andyzhp234/8-Bit-Breadboard-Computer/RAM_Programmer/README.md

# Code to Program the RAM Modules of the 8-bit computer

This RAM Programmer is designed to facilitate the loading of programs from a PC into an 8-bit breadboard computer via an Arduino interface.

## Basic Commands:

NOP : No Operations <br>
LDA : Load from memory to A <br>
ADD : Add from memory with current A and store in A <br>
SUB : Same above but sub <br>
STA : Store value in Register A to Memory <br>
LDI : Load Immediate values To A <br>
JMP : JMP to specific lines <br>
JC  : Jump when Carry flag is on <br>
JZ  : Jump when zero flag is on <br>
OUT : Output to 7-segment LED <br>
HLT : Halt the program <br>
