andyzhp234/8-Bit-Breadboard-Computer/Images/IMG_3965.jpg

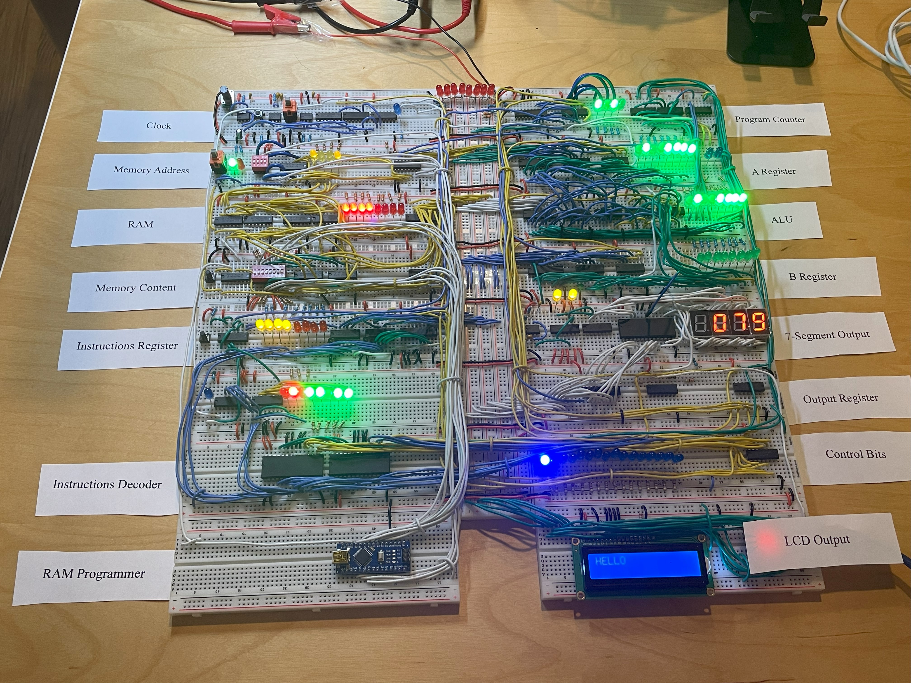
Images/IMG_3965.jpg
