andyzhp234/8-Bit-Breadboard-Computer/Schematics/a-register.png

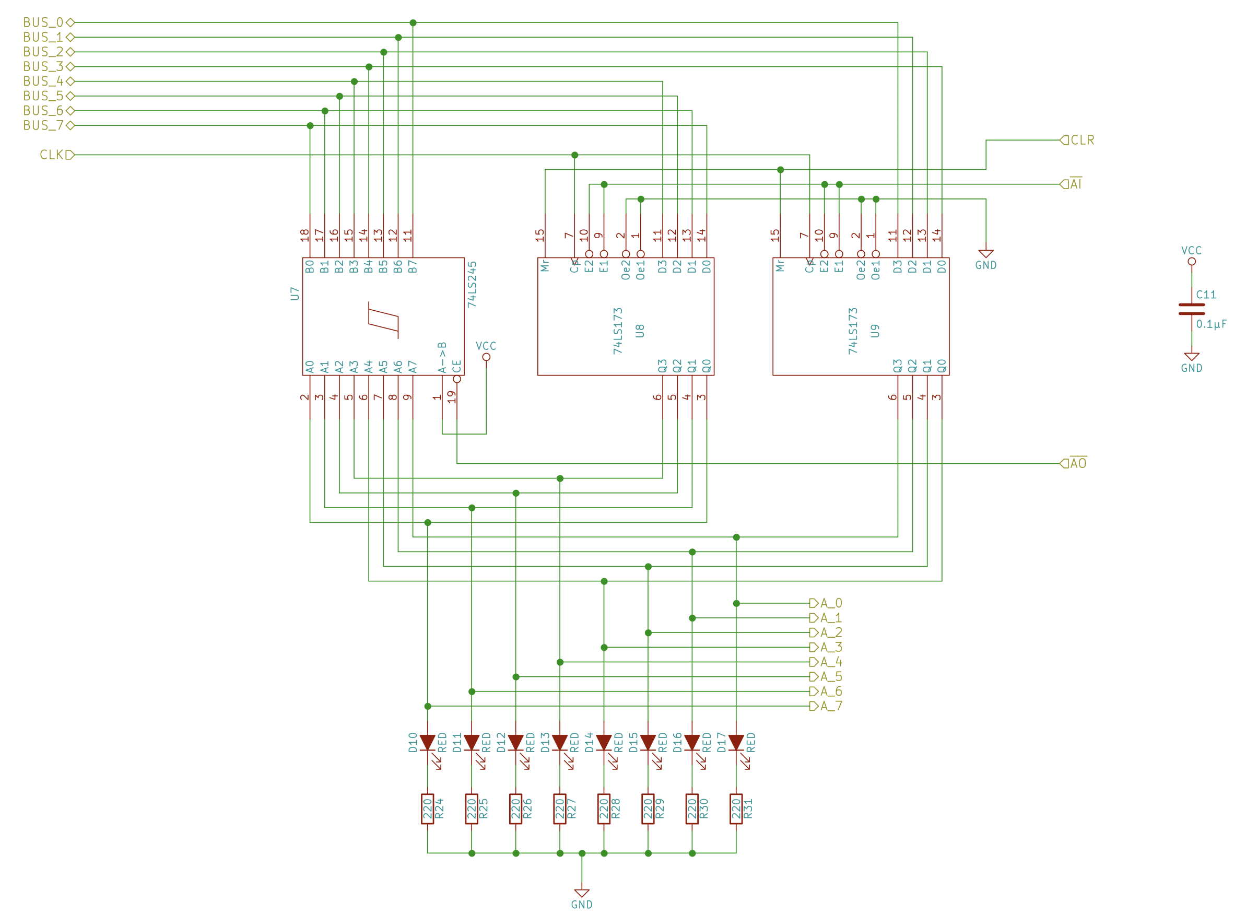
Schematics/a-register.png
