andyzhp234/8-Bit-Breadboard-Computer/Schematics/alu.png

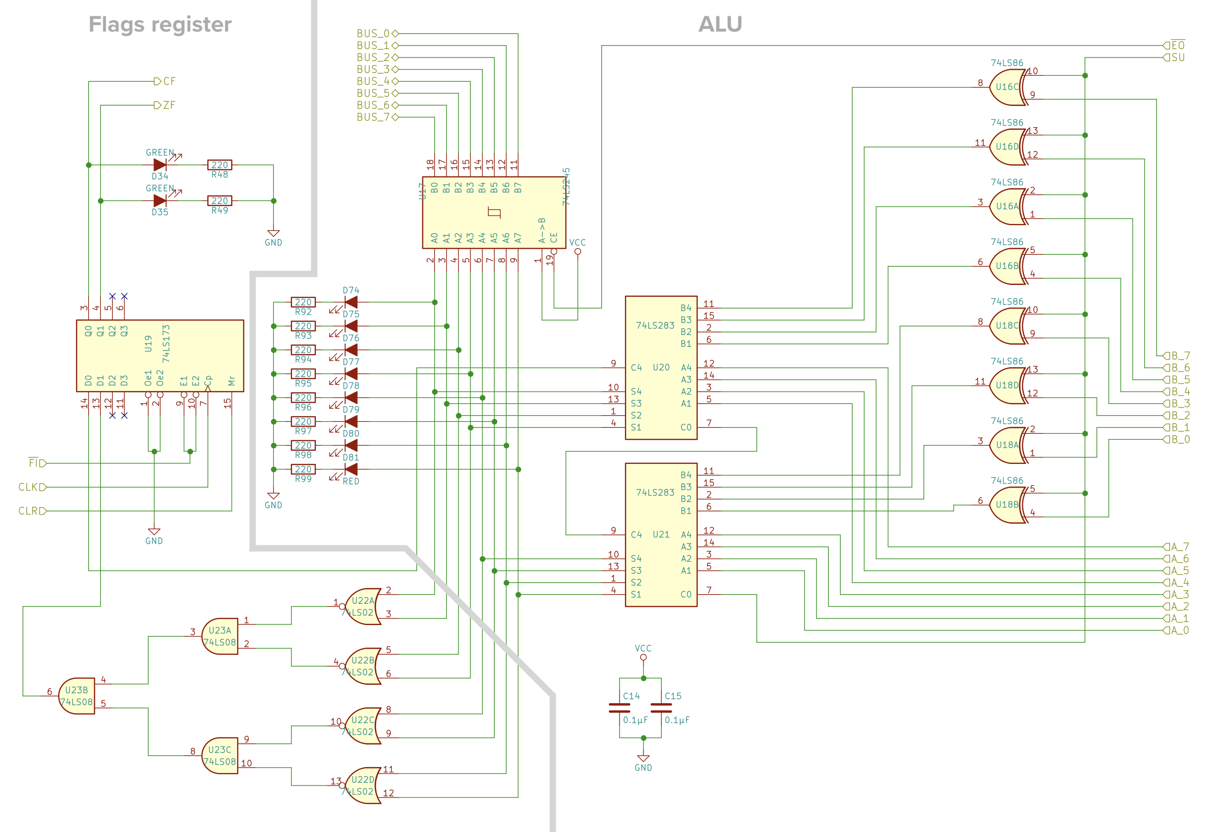
Schematics/alu.png
