andyzhp234/8-Bit-Breadboard-Computer/Schematics/b-register.png

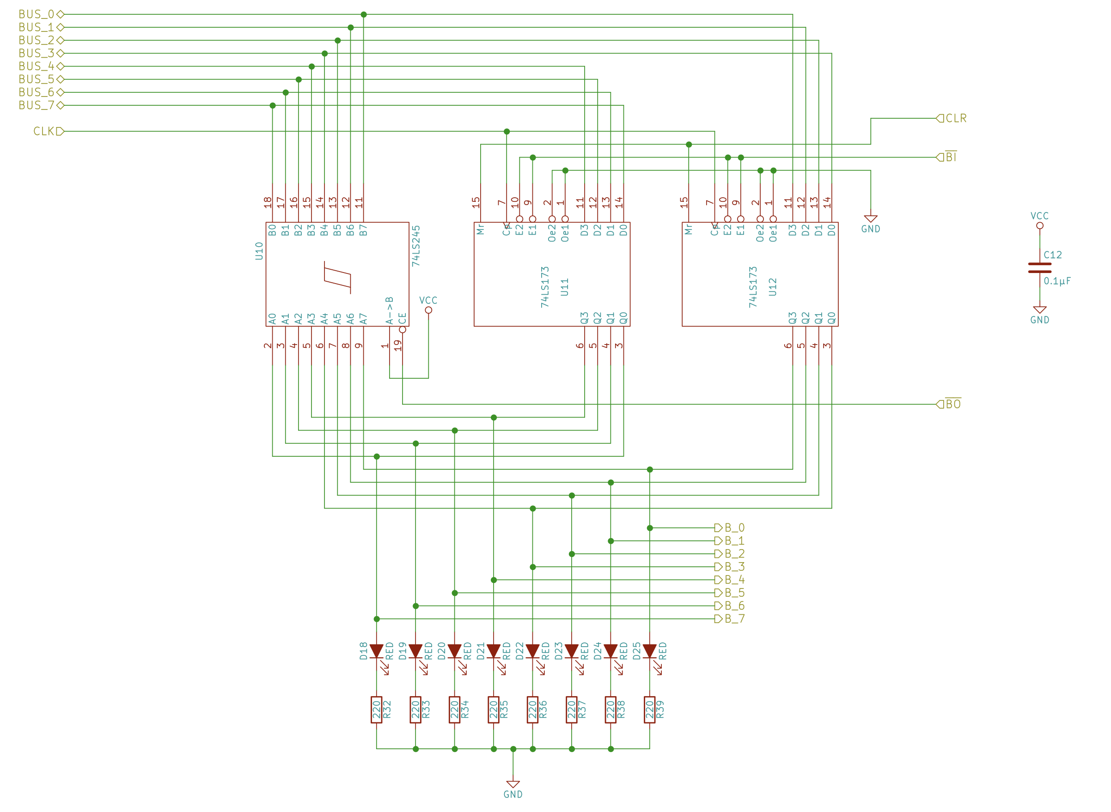
Schematics/b-register.png
