andyzhp234/8-Bit-Breadboard-Computer/Schematics/clock.png

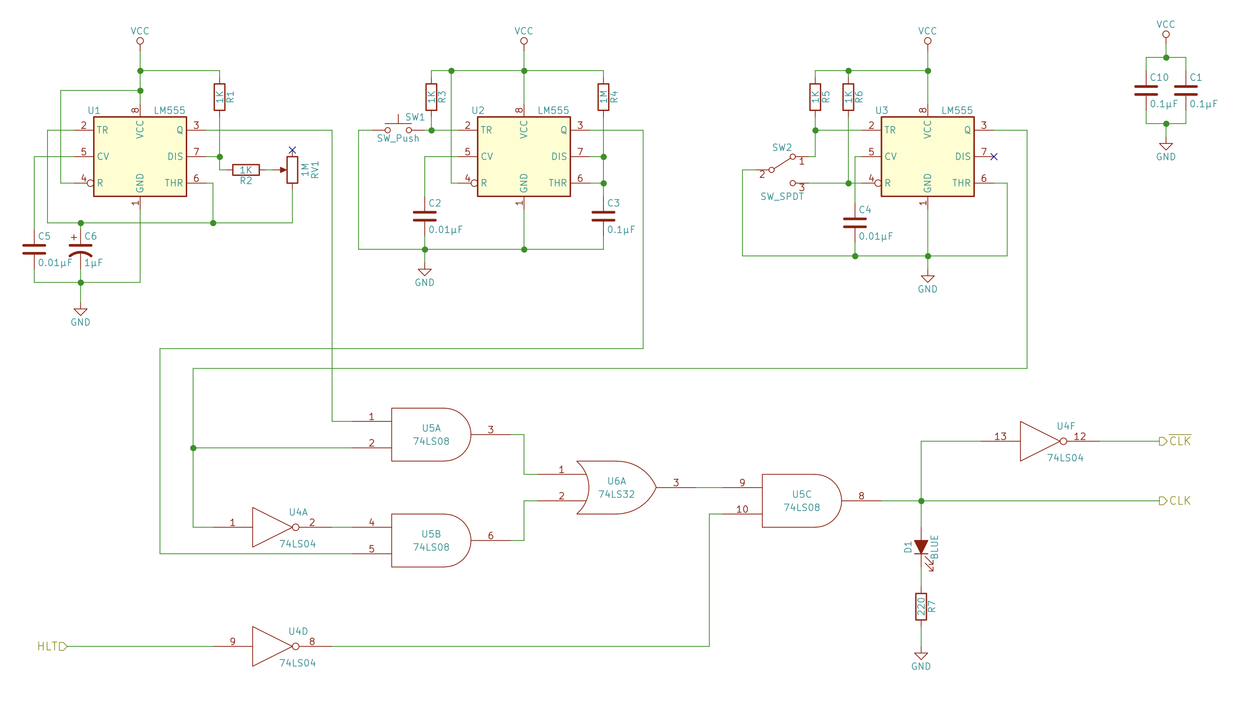
Schematics/clock.png
