andyzhp234/8-Bit-Breadboard-Computer/Schematics/control.png

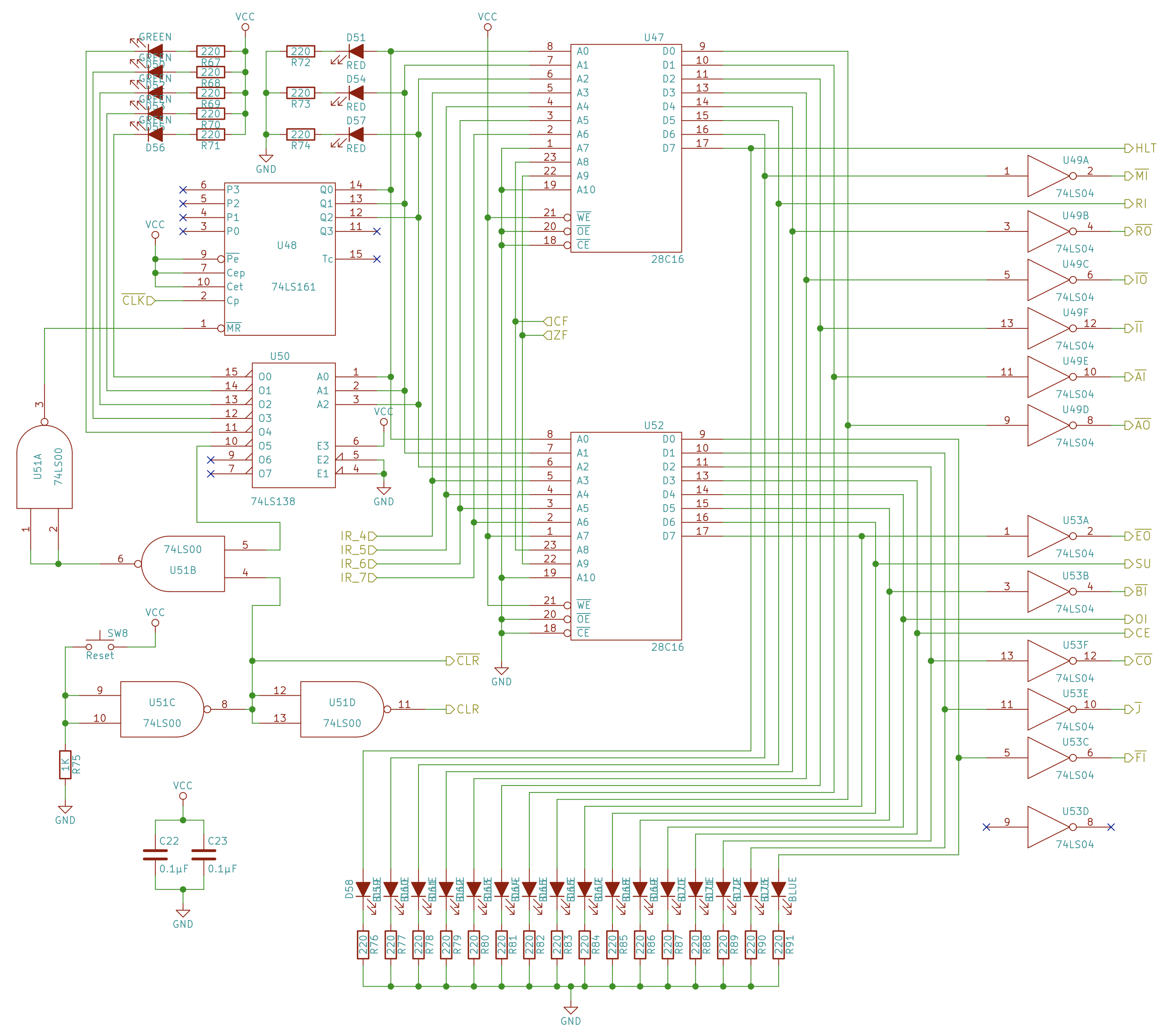
Schematics/control.png
