andyzhp234/8-Bit-Breadboard-Computer/Schematics/memory_address_register.png

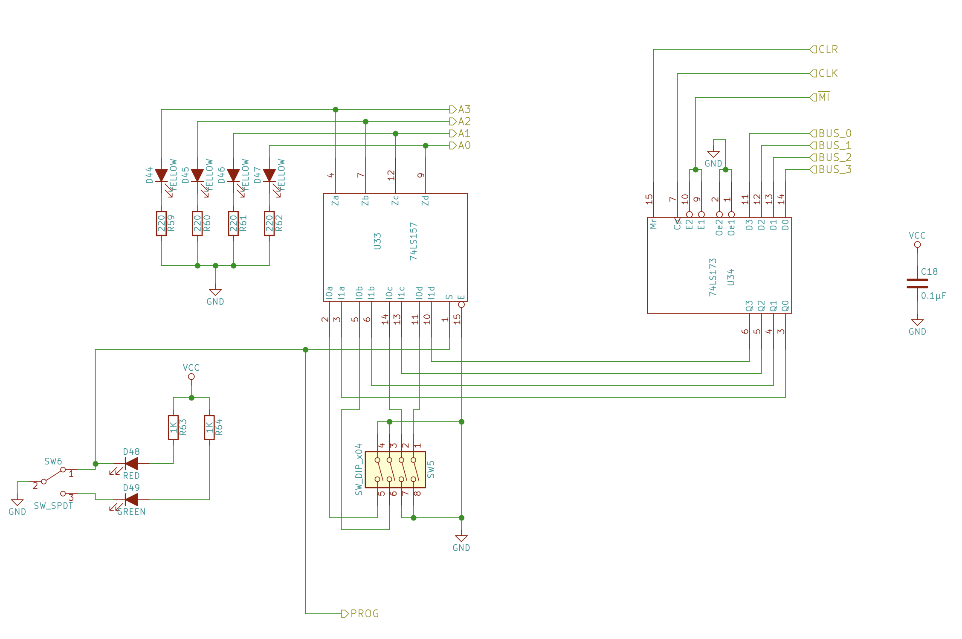
Schematics/memory_address_register.png
