andyzhp234/8-Bit-Breadboard-Computer/Schematics/output.png

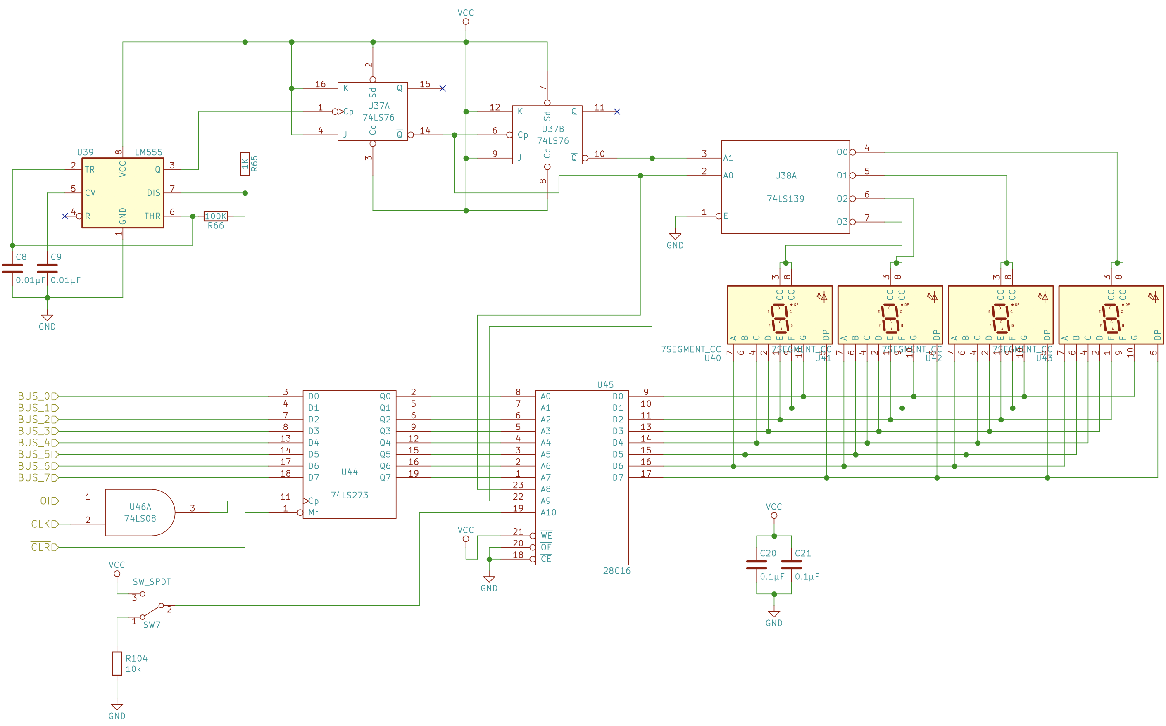
Schematics/output.png
