andyzhp234/8-Bit-Breadboard-Computer/Schematics/program_counter.png

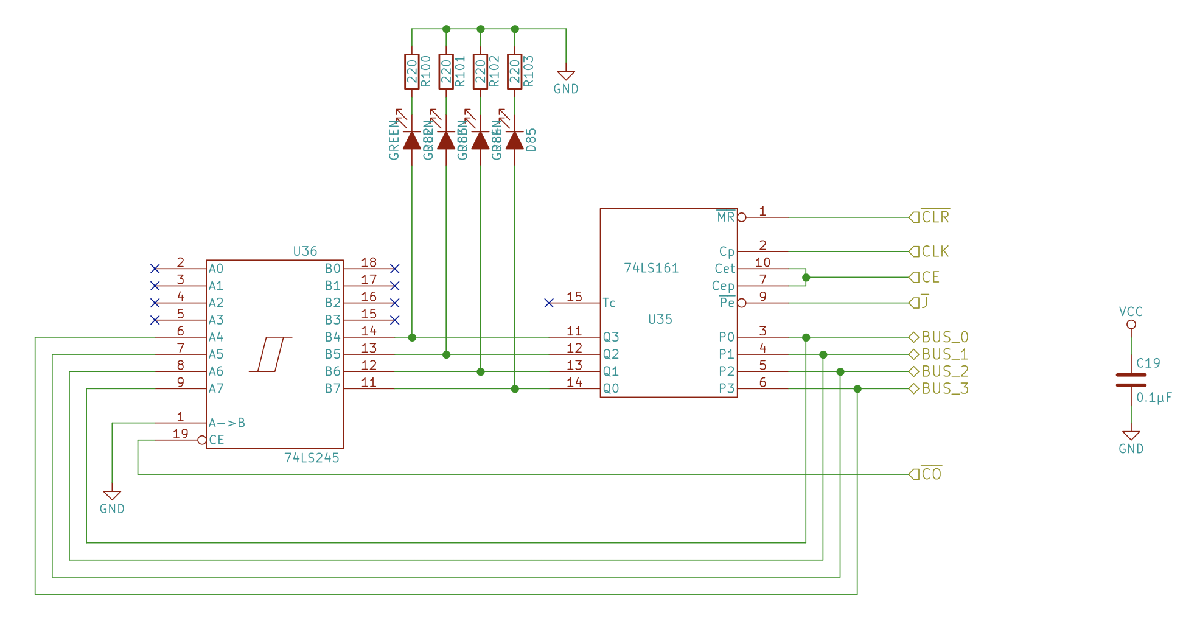
Schematics/program_counter.png
