andyzhp234/8-Bit-Breadboard-Computer/Schematics/ram.png

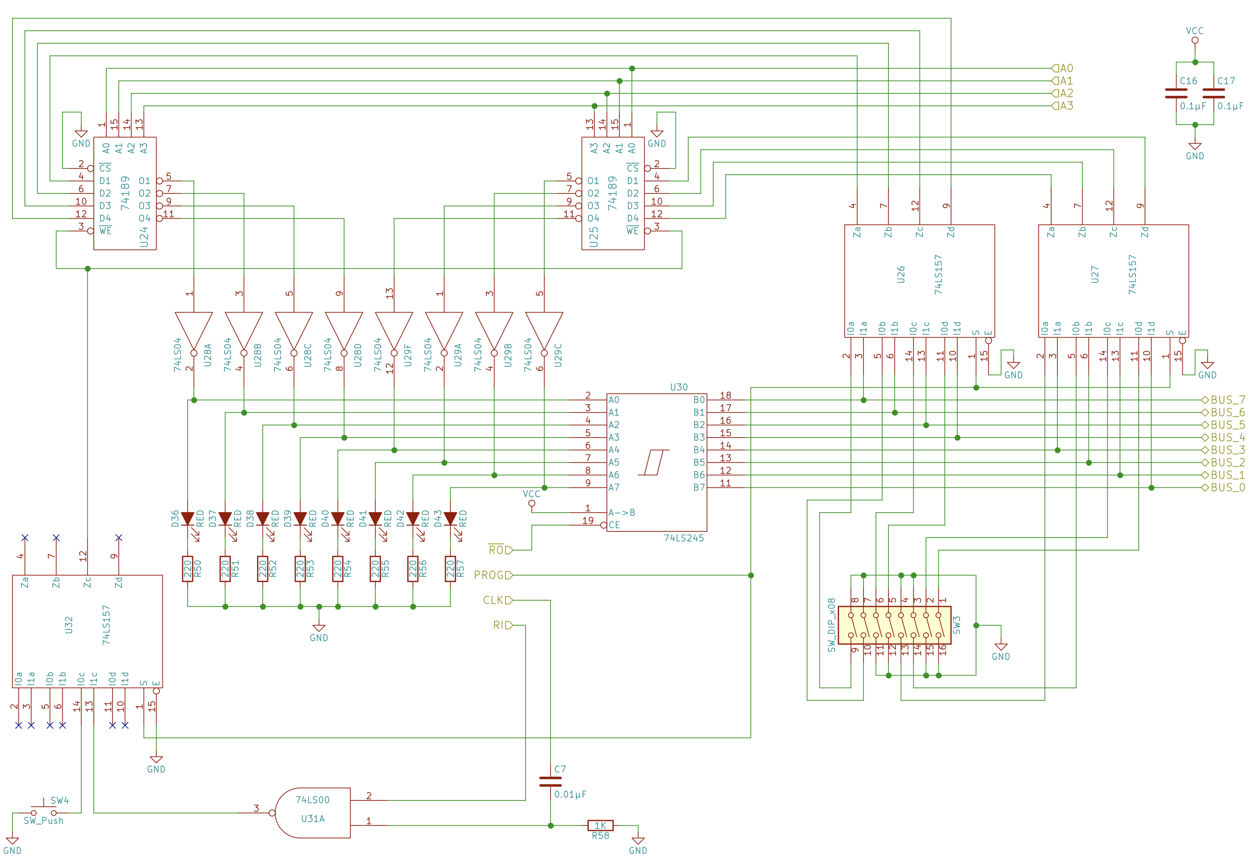
Schematics/ram.png
