andyzhp234/8-Bit-Breadboard-Computer/Schematics/instruction_register.png

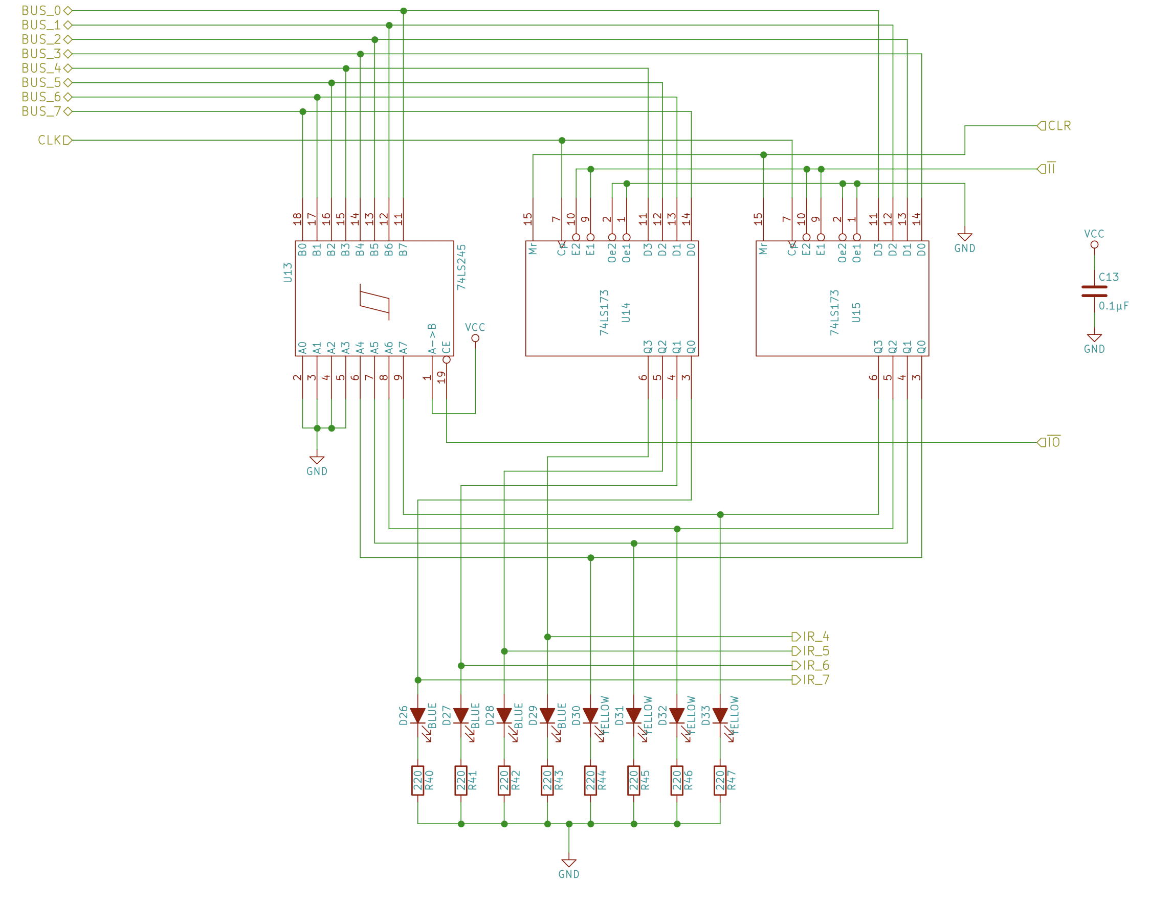
Schematics/instruction_register.png
