andyzhp234/8-Bit-Breadboard-Computer/Images/IMG_3950.jpg

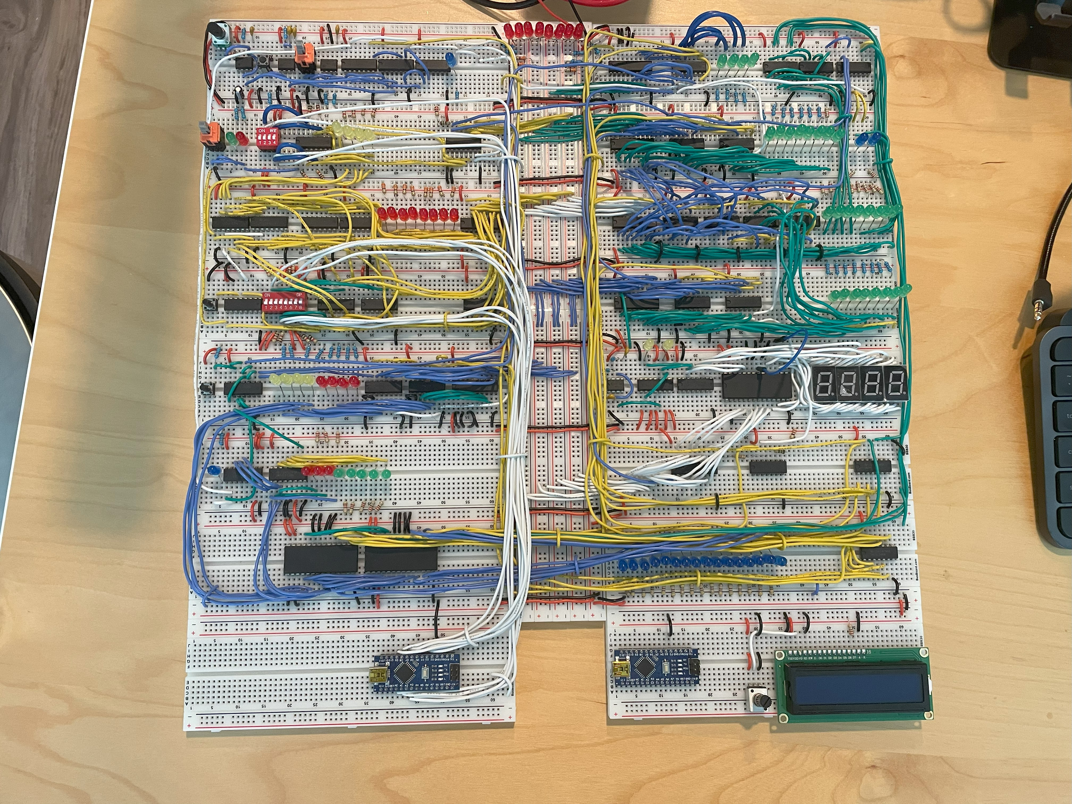
[picture p1: Images/IMG_3950.jpg]
Images/IMG_3950.jpg
